PunderWorks/DroidCANBridge/PCB/production/bom/DroidCANBridge-bom.csv

Refs | Quantity | Value | Footprint | MF | MPN | LCSC | Mouser | DigiKey | Hand | DNP
C4,C6,C7 | 3 | 100nF | Capacitor_SMD:C_0603_1608Metric | YAGEO | CC0603KRX7R9BB104 | C14663
R4 | 1 | 10kΩ | Resistor_SMD:R_0603_1608Metric | UNI-ROYAL | 0603WAF1002T5E | C25804
R1 | 1 | 120Ω | Resistor_SMD:R_0805_2012Metric | UNI-ROYAL | 0805W8F1200T5E | C17437
R2,R3 | 2 | 1kΩ | Resistor_SMD:R_0603_1608Metric | UNI-ROYAL | 0603WAF1001T5E | C21190
C2,C3,C8 | 3 | 1µF | Capacitor_SMD:C_0603_1608Metric | Samsung Electro-Mechanics | CL10A105KB8NNNC | C15849
J7 | 1 | 3V3 | VIO | 5V | Connector_PinHeader_2.54mm:PinHeader_1x03_P2.54mm_Vertical | XFCN | PZ254V-11-03P | C2937625 |  |  | Yes | Yes
C1,C5 | 2 | 4.7µF | Capacitor_SMD:C_0603_1608Metric | Samsung Electro-Mechanics | CL10A475KO8NNNC | C19666
U1 | 1 | AP2112K-3.3 | Package_TO_SOT_SMD:SOT-23-5 | Diodes Incorporated | AP2112K-3.3TRG1 | C51118 | 621-AP2112K-3.3TRG1
D3 | 1 | BAT54S | Package_TO_SOT_SMD:SOT-23 | MDD (Microdiode Semiconductor) | BAT54S | C408389
Q1 | 1 | BSS138 | Package_TO_SOT_SMD:SOT-23 | onsemi | BSS138 | C52895
J8 | 1 | FTDI | Connector_PinHeader_2.54mm:PinHeader_1x06_P2.54mm_Vertical | XFCN | PZ254V-11-06P | C492405 |  |  | Yes | Yes
J3,J4,J6 | 3 | JST XH 2-pin | Connector_JST:JST_XH_B2B-XH-A_1x02_P2.50mm_Vertical | JST | B2B-XH-A(LF)(SN) | C158012 |  |  | Yes | Yes
H1,H2 | 2 | MountingHole | MountingHole:MountingHole_3.2mm_M3
D1,D2 | 2 | SS14 | Diode_SMD:D_SMA | MDD (Microdiode Semiconductor) | SS14 | C2480
U2 | 1 | STM32C092FxPx | Package_SO:TSSOP-20_4.4x6.5mm_P0.65mm | STMicroelectronics | STM32C092FCP6 | C44847704 | 511-STM32C092FCP6
U3 | 1 | TCAN334G | Package_SO:SOIC-8_3.9x4.9mm_P1.27mm | Texas Instruments | TCAN334GDR | C189939 | 595-TCAN334GDR
J5 | 1 | TERM | Connector_PinHeader_2.54mm:PinHeader_1x02_P2.54mm_Vertical | XFCN | PZ254V-11-02P | C492401 |  |  | Yes | Yes
SW1 | 1 | TS-1187A-B-A-B | DroidCANBridge:XKB_TS-1187A-B-A-B | XKB Connection | TS-1187A-B-A-B | C318884
J1,J2 | 2 | WAGO 2601-1102 | DroidCANBridge:WAGO_2601-1102_Horizontal | WAGO | 2601-1102 | C7509568 |  |  | Yes | Yes
