PunderWorks/DroidCANBridge/PCB/DroidCANBridge.kicad_pcb

## KiCad design PCB/DroidCANBridge.kicad_pcb (2026-11-10)

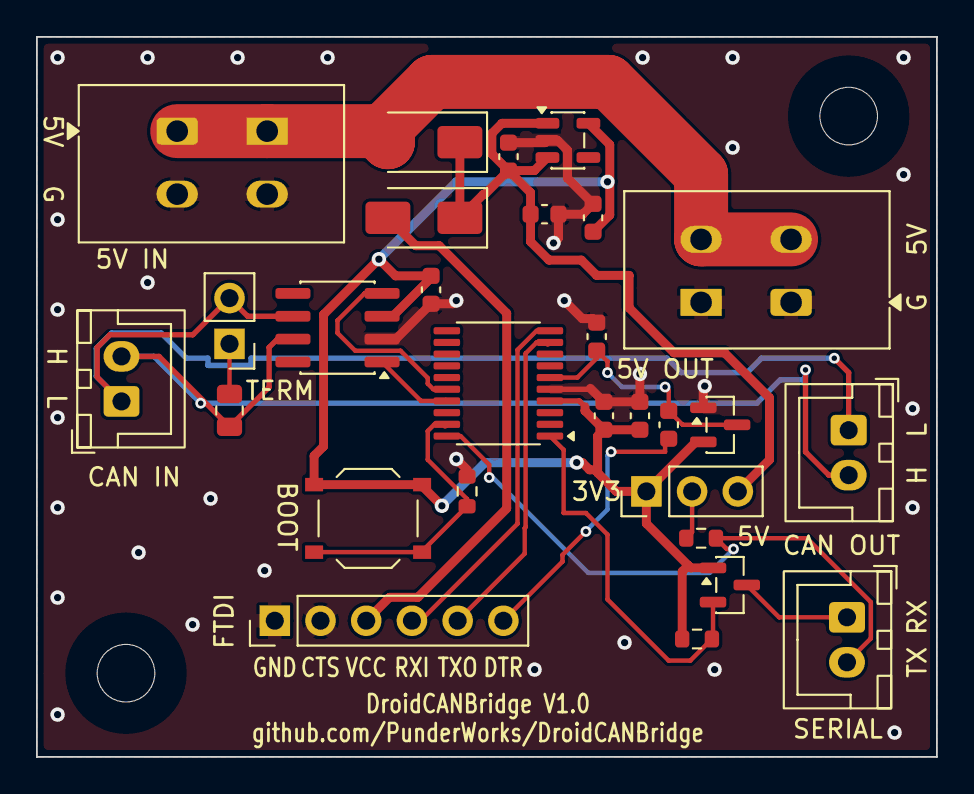
[picture p3: board DroidCANBridge.kicad_pcb from above]

Board: 2 copper layers, 50.0 x 40.0 mm, 31 parts (1 on the bottom side), 19 nets.

Parts:
C1, C5: 4.7µF; C_0603_1608Metric
C2, C3, C8: 1µF; C_0603_1608Metric
C4, C6, C7: 100nF; C_0603_1608Metric
D1, D2: SS14; D_SMA
D3: BAT54S; SOT-23
H1, H2: MountingHole; MountingHole_3.2mm_M3
J1, J2: WAGO 2601-1102; WAGO_2601-1102_Horizontal
J3, J4, J6: JST XH 2-pin; JST_XH_B2B-XH-A_1x02_P2.50mm_Vertical
J5: TERM; PinHeader_1x02_P2.54mm_Vertical
J7: 3V3 | VIO | 5V; PinHeader_1x03_P2.54mm_Vertical
J8: FTDI; PinHeader_1x06_P2.54mm_Vertical
LOGO**: PunderWorks_Logo_14mm
Q1: BSS138; SOT-23
R1: 120Ω; R_0805_2012Metric
R2, R3: 1kΩ; R_0603_1608Metric
R4: 10kΩ; R_0603_1608Metric
SW1: TS-1187A-B-A-B; XKB_TS-1187A-B-A-B
U1: AP2112K-3.3; SOT-23-5
U2: STM32C092FxPx; TSSOP-20_4.4x6.5mm_P0.65mm
U3: TCAN334G; SOIC-8_3.9x4.9mm_P1.27mm

Connections:
+3V3: C3.1, C4.1, C5.1, C7.1, D3.2, J7.1, Q1.1, R3.2, SW1.1, U1.5, U2.4, U3.3
+5V_IN: D1.2, J1.1, J2.2
BOOT0: R4.1, SW1.2, U2.19
CANH: J3.2, J4.2, R1.1, U3.7
CANL: J3.1, J4.1, J5.2, U3.6
CAN_RX: U2.16, U3.4
CAN_TX: U2.17, U3.1
FTDI_DTR: C8.1, J8.6
FTDI_RXD: J8.5, U2.9
FTDI_TXD: J8.4, U2.10
FTDI_VCC: D2.2, J8.3
GND: C1.2, C2.2, C3.2, C4.2, C5.2, C6.2, C7.2, D3.1, J1.2, J2.1, J8.1, J8.2, R4.2, U1.2, U2.5, U3.2
NRST: C6.1, C8.2, D3.3, U2.6
unnamed: J5.1, R1.2
UART_RX: J6.1, Q1.3
UART_RX_3V3: Q1.2, R3.1, U2.1
UART_TX: J6.2, R2.2, U2.20
UART_VIO: J7.2, R2.1
VSYS: C1.1, C2.1, D1.1, D2.1, J7.3, U1.1, U1.3
