PunderWorks/DroidCANBridge/(commit log)

2026-11-06 Initial scaffold for the DroidCANAdapter board
    Repository layout for the CAN <-> UART adapter: PCB/ for the Stackup
    design and KiCad project, ci/ with the Cargo-locked Stackup CLI (0.2.0)
    and the PCB sync check, manifest.kdl pinning the parts library, and the
    STM32C092 datasheet. PCB/README.md records the requirements and the
    decisions so far (STM32C092 TSSOP-20, CAN FD hardware with classic CAN
    firmware first, JST-XH, WAGO power with passthrough, FTDI bootloader
    header). CLAUDE.md is cleaned of notes carried over from Amidala.
2026-11-06 Add the Stackup design, KiCad board and CI (#1)
    * Add the Stackup design, KiCad board and CI for the adapter
    The electrical design in PCB/stackup: an STM32C092FCP6 (TSSOP-20, a local
    part since the library only has LQFP) with a TCAN334G 3.3 V CAN FD
    transceiver; two JST-XH CAN connectors with a jumpered 120 ohm terminator;
    a JST-XH UART with a jumper-selected 3.3 V / 5 V level (open-drain TX,
    BSS138 RX shifter); 5 V in on a WAGO terminal with a passthrough, OR-ed
    with the FTDI header's VCC through SS14 diodes; and the FTDI header on the
    ROM bootloader's USART2 with DTR auto-reset, a boot button and SWD pads.
    The KiCad board is synced from the design (footprints only; layout is
    next). CI ch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
    [DroidCANAdapter.kicad_pcb]
2026-11-06 Final board review: DTR reset simulation, hole keep-outs, stitching vias (#2)
    * Add the DTR reset simulation and record the final board review
    scripts/spice/dtr_reset.py simulates the FTDI DTR auto-reset on NRST
    over 3.3 V and 5 V cables, stiff and weak drivers, and the NRST pull-up
    range. With the BAT54S every corner passes: a 7-27 ms reset pulse, NRST
    back above VIH in 30-78 ms with DTR still low, at most 0.25 mA into the
    MCU's own clamp, and a 4.3 V peak on port close. Without it the 5 V
    corners fail (7.9 V peak, 26 mA injection), so the clamp is needed.
    PCB/README.md records the simulated NRST numbers, the review's clean
    checks and accepted findings, and the 3.3 V-VCC FTDI adapter cave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
    [DroidCANAdapter.kicad_pcb]
2026-11-06 Rename the project to DroidCANBridge (#3)
    The board translates between CAN and UART, so "bridge" describes it
    better than "adapter". Renamed:
    - KiCad project files (DroidCANBridge.kicad_pcb/.kicad_pro/.stackup_sch),
    the project footprint library (DroidCANBridge.pretty) and the board
    render in PCB/assets.
    - Footprint library references in parts.kdl and fp-lib-table, the
    Cargo package (droidcanbridge-stackup-check) and the CI paths.
    - Silkscreen: the credit line now reads "CAN to UART Bridge V1.0 by
    @thePunderWoman" with github.com/thePunderWoman/DroidCANBridge, and
    the back legend's title is DroidCANBridge.
    - README, CLAUDE.md, PCB README and script docs. "Adapter" now means only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
    [DroidCANBridge.kicad_pcb]
2026-11-08 Add PunderWorks branding, QR code and production files (#4)
    Back silkscreen: PunderWorks logo (14 mm, board-only footprint copied
    from DroidPowerSense with its source PNG), board name and version, the
    repo URL, and a 6.2 mm QR code to github.com/PunderWorks/DroidCANBridge.
    This replaces the back pinout legend. Front URL moved from
    thePunderWoman to the PunderWorks org.
    Production files in PCB/production/: Gerbers, job file and PTH/NPTH
    drills with maps; the Stackup purchasing BOM (LCSC numbers for JLCPCB);
    the placement file with the 20 JLCPCB-placed parts (hand-soldered J1-J8
    left out). DRC 0/0 at all severities, saved fills identical to a refill,
    stackup check 0/0/0.
    README shows front a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
    [DroidCANBridge-B_Cu.gbr, DroidCANBridge-B_Mask.gbr, DroidCANBridge-B_Paste.gbr, DroidCANBridge-B_Silkscreen.gbr, DroidCANBridge-Edge_Cuts.gbr, DroidCANBridge-F_Cu.gbr, DroidCANBridge-F_Mask.gbr, DroidCANBridge-F_Paste.gbr]
2026-11-10 Update Stackup to 0.3.0 and exclude hand parts from BOM and placement (#5)
    Stackup 0.3.0 exports `hand=#true` placements with a `Stackup Hand`
    property, and its KiCad plugin's sync turns that into the footprint's
    "Exclude from position files" and "Exclude from BOM" attributes. Bump the
    Cargo-locked CLI, the manifest and the CI plugin checkout to 0.3.0 and
    resync the board: J1-J8 (WAGO terminals, JST-XH connectors and the TERM,
    VIO and FTDI headers) now carry both attributes, so `kicad-cli pcb export
    pos` leaves them out with no hand filtering and KiCad-based assembly BOMs
    no longer list them. The regenerated position file and purchasing BOM are
    unchanged.
    Also add AGENTS.md, matching CLAUDE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
    [DroidCANBridge.kicad_pcb]
